zedzeck/tcc_acesso_up/README.md

# tcc_acesso_up

Trabalho de Conclusão de Curso desenvolvido para obtenção do título de Bacharel em Engenharia Elétrica pela Universidade Positivo.
